Frrrrrrrrrank/Underwater-Communication/underwaterCom.kicad_pcb

## KiCad design underwaterCom.kicad_pcb (2026-06-12)

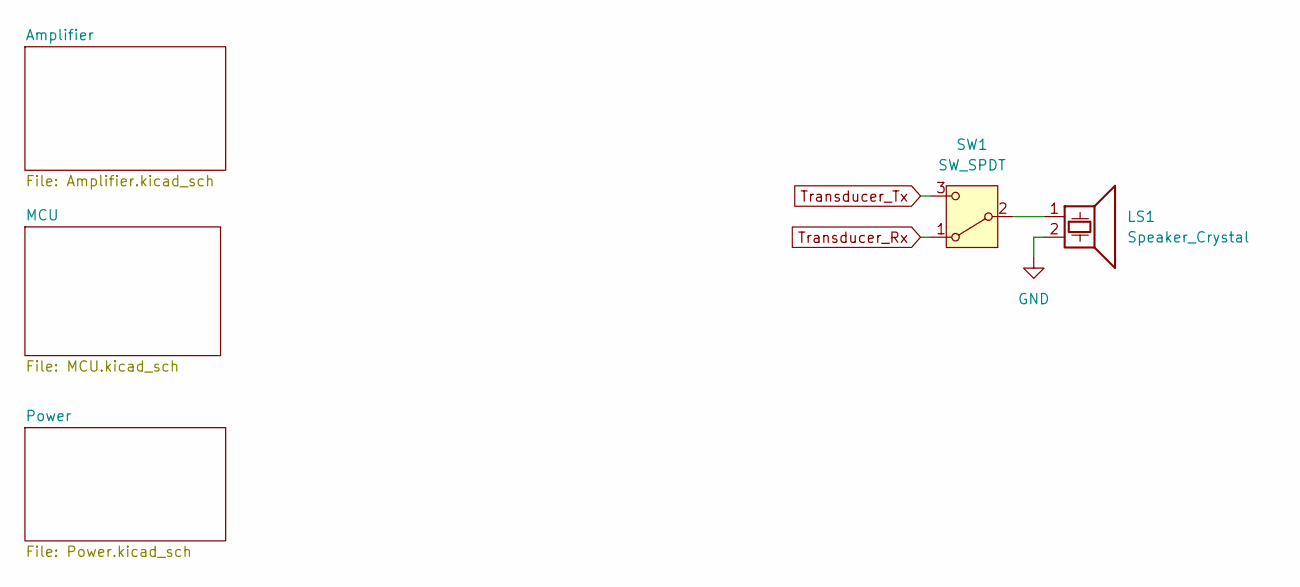
[picture p1: schematic underwaterCom.kicad_sch]

Parts:
LS1: Speaker_Crystal; PinHeader_1x02_P2.54mm_Vertical
SW1: SW_SPDT; Nidec_Copal_CAS-120A

Connections:
GND: LS1.2; also elsewhere on the board
unnamed: LS1.1, SW1.2 (B)
Transducer_Rx: SW1.1 (A); also elsewhere on the board
Transducer_Tx: SW1.3 (C); also elsewhere on the board

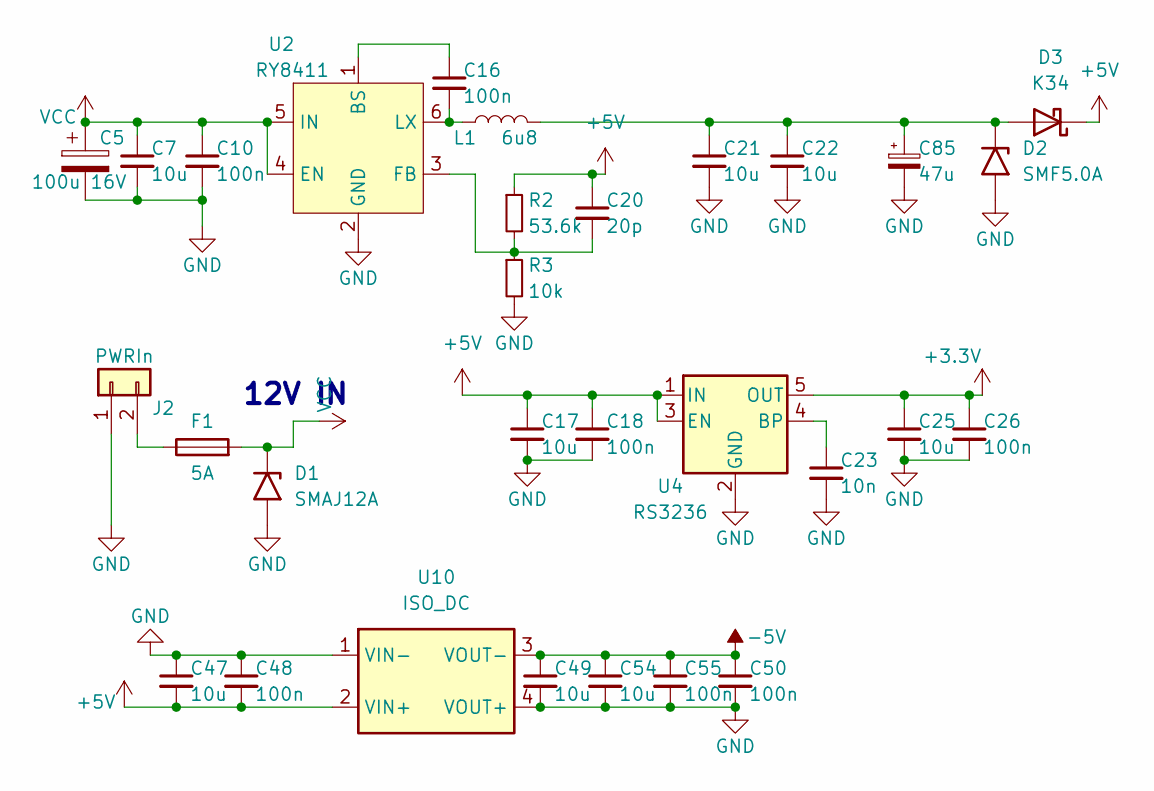
[picture p2: schematic Power.kicad_sch]

Parts:
C5: 100u 16V; CP_Radial_D6.3mm_P2.50mm
C7, C21, C22: 10u; C_1206_3216Metric
C10, C16, C18, C26, C48, C50, C55: 100n; C_0603_1608Metric
C17, C25, C47, C49, C54: 10u; C_0603_1608Metric
C20: 20p; C_0603_1608Metric
C23: 10n; C_0603_1608Metric
C85: 47u; CP_EIA-3216-18_Kemet-A_Pad1.58x1.35mm_HandSolder
D1: SMAJ12A; D_SMA
D2: SMF5.0A; D_SMF
D3: K34; D_SOD-123F
F1: 5A; Fuse_1206_3216Metric
J2: PWRIn; AMASS_XT30U-M_1x02_P5.0mm_Vertical
L1: 6u8; L_Sunlord_MWSA0402S
R2: 53.6k; R_0603_1608Metric
R3: 10k; R_0603_1608Metric
U2: RY8411; SOT-23-6
U4: RS3236; SOT-23-5
U10: ISO_DC; ISO_POWER

Connections:
+3.3V: C25.1, C26.1, U4.5 (OUT); also elsewhere on the board
+5V: C17.1, C18.1, C20.1, C47.2, C48.2, D3.1 (K), R2.1, U4.1 (IN), U4.3 (EN), U10.2 (VIN+); also elsewhere on the board
-5V: C49.1, C50.1, C54.1, C55.1, U10.3 (VOUT-); also elsewhere on the board
GND: C5.2, C7.2, C10.2, C17.2, C18.2, C21.2, C22.2, C23.2, C25.2, C26.2, C47.1, C48.1, C49.2, C50.2, C54.2, C55.2, C85.2, D1.2 (A2), D2.2 (A2), J2.1, R3.2, U2.2 (GND), U4.2 (GND), U10.1 (VIN-), U10.4 (VOUT+); also elsewhere on the board
unnamed: C21.1, C22.1, C85.1, D2.1 (A1), D3.2 (A), L1.2
unnamed: F1.1, J2.2
unnamed: C16.1, U2.1 (BS)
unnamed: C20.2, R2.2, R3.1, U2.3 (FB)
unnamed: C16.2, L1.1, U2.6 (LX)
unnamed: C23.1, U4.4 (BP)
VCC: C5.1, C7.1, C10.1, D1.1 (A1), F1.2, U2.4 (EN), U2.5 (IN); also elsewhere on the board

Notes on the sheet:
12V IN

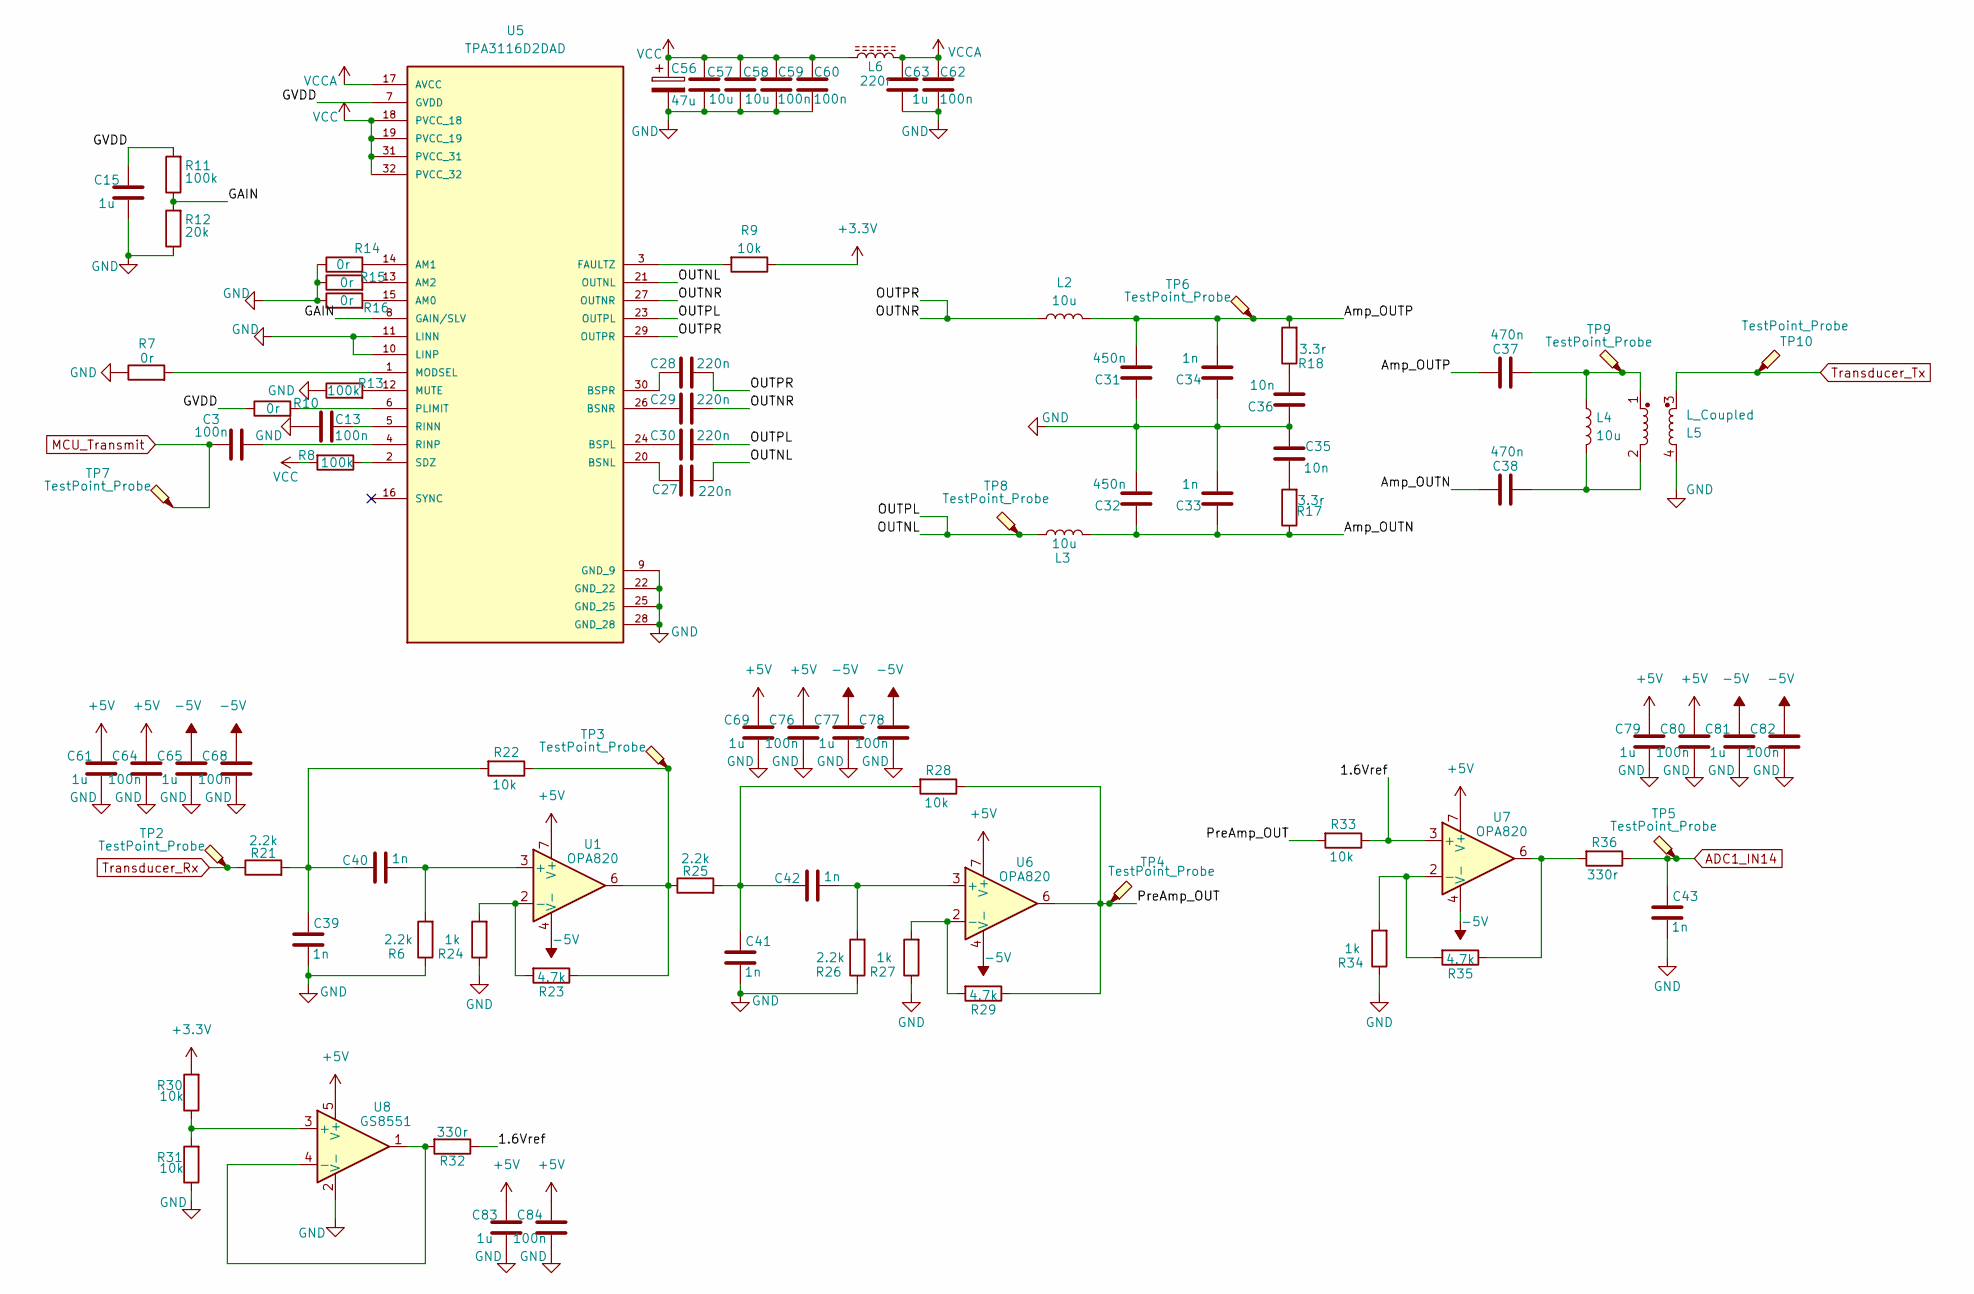
[picture p3: schematic Amplifier.kicad_sch]

Parts:
C3, C13, C59, C60, C62, C64, C68, C76, C78, C80, C82, C84: 100n; C_0603_1608Metric
C15, C61, C63, C65, C69, C77, C79, C81, C83: 1u; C_0603_1608Metric
C27, C28, C29, C30: 220n; C_0603_1608Metric
C31, C32: 450n; C_0603_1608Metric
C33, C34, C39, C40, C41, C42, C43: 1n; C_0603_1608Metric
C35, C36: 10n; C_0603_1608Metric
C37, C38: 470n; C_1206_3216Metric
C56: 47u; CP_Radial_D6.3mm_P2.50mm
C57, C58: 10u; C_1206_3216Metric
L2, L3, L4: 10u; L_Sunlord_MWSA0402S
L5: L_Coupled; L_CommonModeChoke_TDK_ATB322515
L6: 220r; L_0603_1608Metric
R6, R21, R25, R26: 2.2k; R_0603_1608Metric
R7, R10, R14, R15, R16: 0r; R_0603_1608Metric
R8, R11, R13: 100k; R_0603_1608Metric
R9, R22, R28, R30, R31, R33: 10k; R_0603_1608Metric
R12: 20k; R_0603_1608Metric
R17, R18: 3.3r; R_0603_1608Metric
R23, R29, R35: 4.7k; R_0603_1608Metric
R24, R27, R34: 1k; R_0603_1608Metric
R32, R36: 330r; R_0603_1608Metric
TP2, TP3, TP4, TP5, TP6, TP7, TP8, TP9, TP10: TestPoint_Probe; Testpoint_1.2_0.8
U1, U6, U7: OPA820; SOIC-8_3.9x4.9mm_P1.27mm
U5: TPA3116D2DAD; SOP65P810X115-32N; PARTREV G
U8: GS8551; SOT-23-5

Connections:
+3.3V: R9.1, R30.2; also elsewhere on the board
+5V: C61.2, C64.2, C69.2, C76.2, C79.2, C80.2, C83.2, C84.2, U1.7 (V+), U6.7 (V+), U7.7 (V+), U8.5 (V+); also elsewhere on the board
-5V: C65.2, C68.2, C77.2, C78.2, C81.2, C82.2, U1.4 (V-), U6.4 (V-), U7.4 (V-); also elsewhere on the board
/Amplifier/1.6Vref: R32.1, R33.1, U7.3 (+)
/Amplifier/Amp_OUTN: C32.2, C33.2, C38.1, L3.2, R17.1
/Amplifier/Amp_OUTP: C31.1, C34.1, C37.1, L2.2, R18.2, TP6.1
/Amplifier/GAIN: R11.1, R12.2, U5.8 (GAIN/SLV)
/Amplifier/GVDD: C15.2, R10.1, R11.2, U5.7 (GVDD)
/Amplifier/OUTNL: C27.1, C30.1, L3.1, TP8.1, U5.21 (OUTNL), U5.23 (OUTPL)
/Amplifier/OUTNR: C28.1, C29.1, L2.1, U5.27 (OUTNR), U5.29 (OUTPR)
/Amplifier/PreAmp_OUT: R28.1, R29.1, R33.2, TP4.1, U6.6
ADC1_IN14: C43.2, R36.1, TP5.1; also elsewhere on the board
GND: C13.1, C15.1, C31.2, C32.1, C33.1, C34.2, C35.2, C36.2, C39.1, C41.1, C43.1, C56.2, C57.2, C58.2, C59.1, C60.1, C61.1, C62.1, C63.1, C64.1, C65.1, C68.1, C69.1, C76.1, C77.1, C78.1, C79.1, C80.1, C81.1, C82.1, C83.1, C84.1, L5.4, R6.1, R7.1, R12.1, R13.1, R14.1, R15.1, R16.1, R24.1, R26.1, R27.1, R31.1, R34.1, U5.9 (GND_9), U5.10 (LINP), U5.11 (LINN), U5.22 (GND_22), U5.25 (GND_25), U5.28 (GND_28), U8.2 (V-); also elsewhere on the board
MCU_Transmit: C3.1, TP7.1; also elsewhere on the board
unnamed: C35.1, R17.2
unnamed: C36.1, R18.1
unnamed: C37.2, L4.1, L5.1, TP9.1
unnamed: C38.2, L4.2, L5.2
unnamed: C39.2, C40.2, R21.2, R22.2
unnamed: C41.2, C42.2, R25.2, R28.2
unnamed: R22.1, R23.1, R25.1, TP3.1, U1.6
unnamed: R35.1, R36.2, U7.6
unnamed: C40.1, R6.2, U1.3 (+)
unnamed: R23.2, R24.2, U1.2 (-)
unnamed: R16.2, U5.15 (AM0)
unnamed: R14.2, U5.14 (AM1)
unnamed: R15.2, U5.13 (AM2)
unnamed: C27.2, U5.20 (BSNL)
unnamed: C29.2, U5.26 (BSNR)
unnamed: C30.2, U5.24 (BSPL)
unnamed: C28.2, U5.30 (BSPR)
unnamed: R9.2, U5.3 (FAULTZ)
unnamed: R7.2, U5.1 (MODSEL)
unnamed: R13.2, U5.12 (MUTE)
unnamed: R10.2, U5.6 (PLIMIT)
unnamed: C13.2, U5.5 (RINN)
unnamed: C3.2, U5.4 (RINP)
unnamed: R8.1, U5.2 (SDZ)
unnamed: C42.1, R26.2, U6.3 (+)
unnamed: R27.2, R29.2, U6.2 (-)
unnamed: R34.2, R35.2, U7.2 (-)
unnamed: R30.1, R31.2, U8.3 (+)
unnamed: R32.2, U8.1, U8.4 (-)
Transducer_Rx: R21.1, TP2.1; also elsewhere on the board
Transducer_Tx: L5.3, TP10.1; also elsewhere on the board
VCC: C56.1, C57.1, C58.1, C59.2, C60.2, L6.1, R8.2, U5.18 (PVCC_18), U5.19 (PVCC_19), U5.31 (PVCC_31), U5.32 (PVCC_32); also elsewhere on the board
VCCA: C62.2, C63.2, L6.2, U5.17 (AVCC)

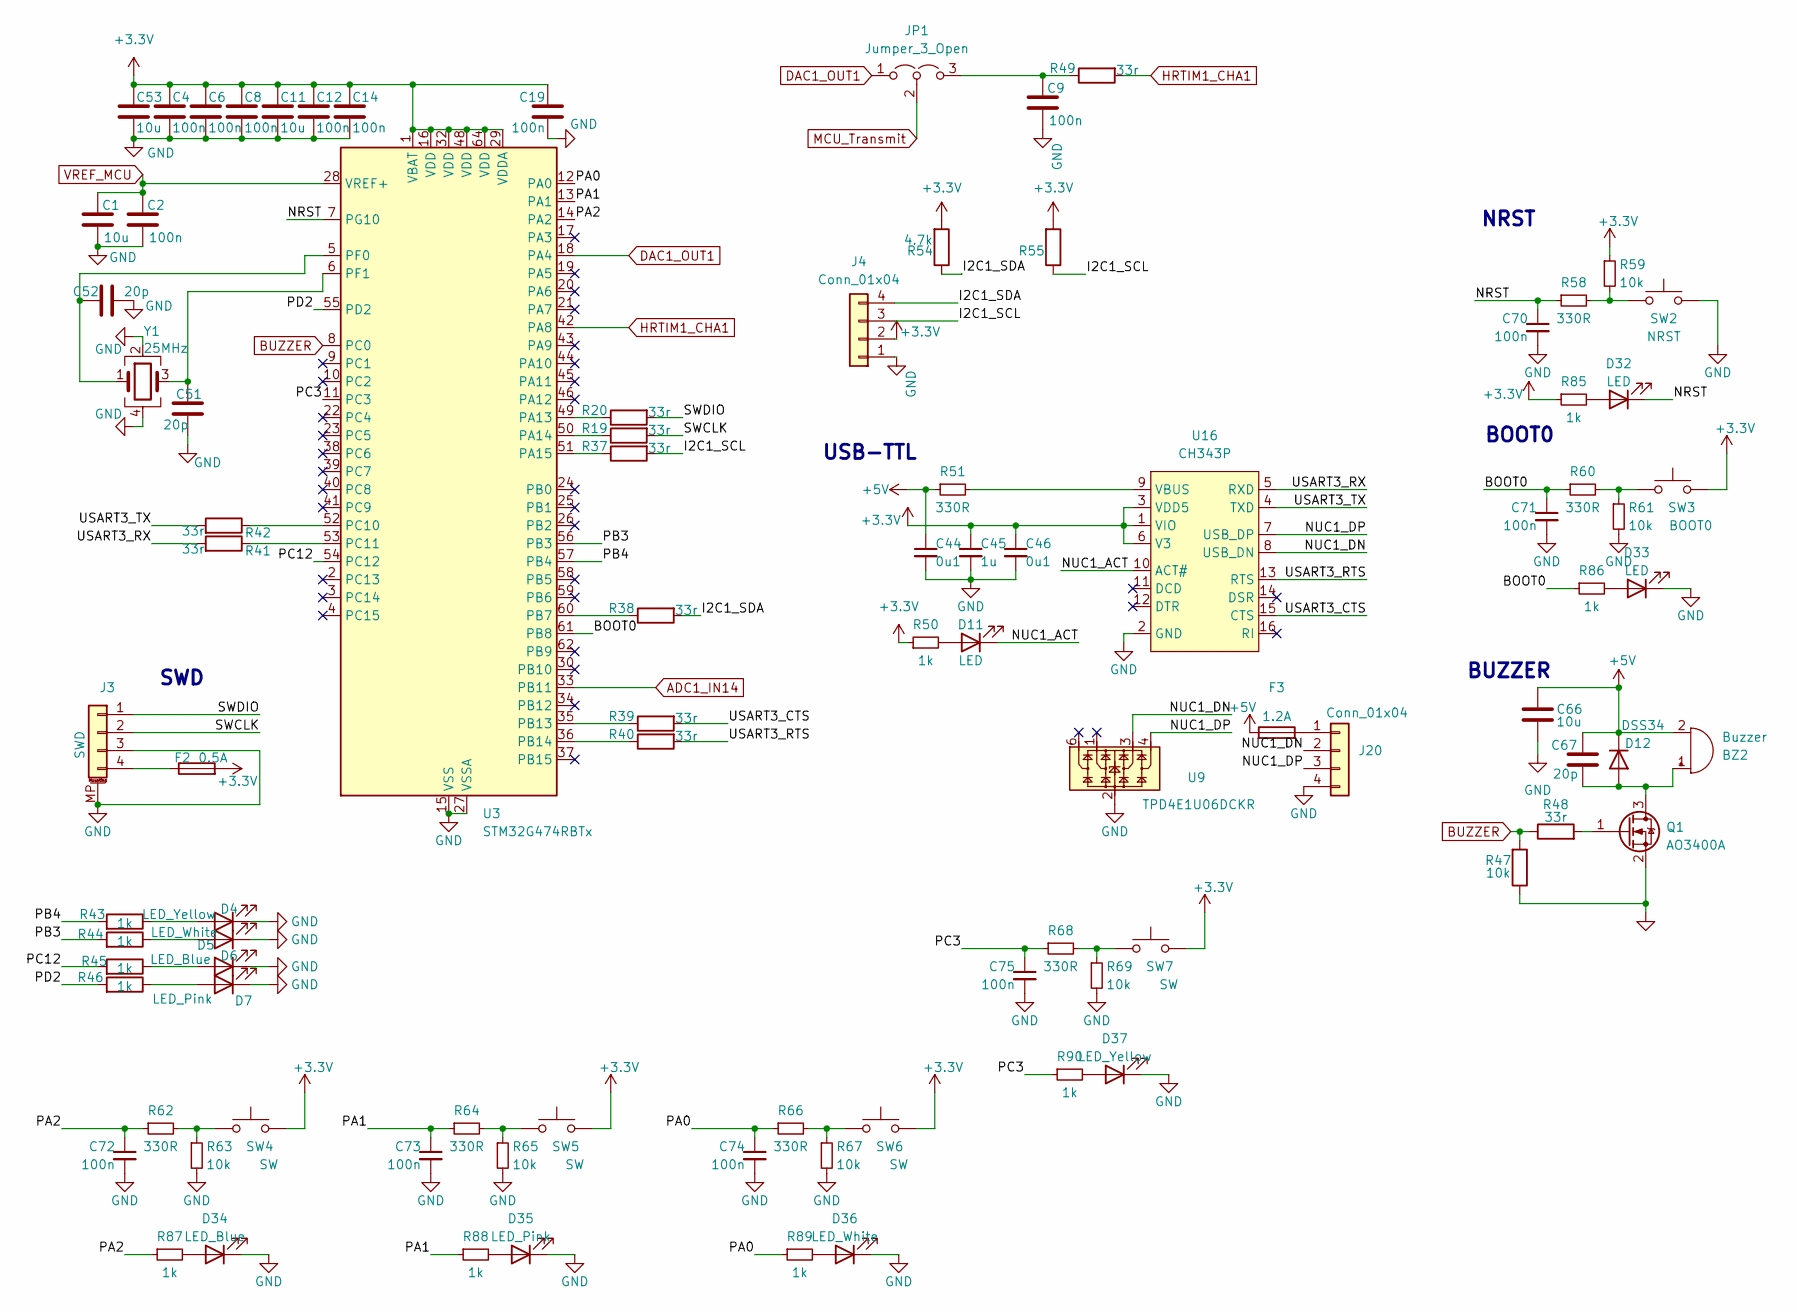
[picture p4: schematic MCU.kicad_sch]

Parts:
BZ2: Buzzer; MLT-9032
C1, C11, C53, C66: 10u; C_0603_1608Metric
C2, C4, C6, C8, C9, C12, C14, C19, C70, C71, C72, C73, C74, C75: 100n; C_0603_1608Metric
C44, C46: 0u1; C_0603_1608Metric
C45: 1u; C_0603_1608Metric
C51, C52, C67: 20p; C_0603_1608Metric
D4, D37: LED_Yellow; LED_0603_1608Metric
D5, D36: LED_White; LED_0603_1608Metric
D6, D34: LED_Blue; LED_0603_1608Metric
D7, D35: LED_Pink; LED_0603_1608Metric
D11, D32, D33: LED; LED_0603_1608Metric
D12: DSS34; D_SMF
F2: 0.5A; Fuse_1206_3216Metric
F3: 1.2A; Fuse_1210_3225Metric
J3: SWD; Molex_PicoBlade_53261-0471_1x04-1MP_P1.25mm_Horizontal
J4: Conn_01x04; PinHeader_1x04_P2.54mm_Vertical
J20: Conn_01x04; JST_PH_B4B-PH-K_1x04_P2.00mm_Vertical
JP1: Jumper_3_Open; PinHeader_1x03_P1.00mm_Vertical
Q1: AO3400A; SOT-23
R19, R20, R37, R38, R39, R40, R41, R42, R48, R49: 33r; R_0603_1608Metric
R43, R44, R45, R46, R50, R85, R86, R87, R88, R89, R90: 1k; R_0603_1608Metric
R47, R59, R61, R63, R65, R67, R69: 10k; R_0603_1608Metric
R51, R58, R60, R62, R64, R66, R68: 330R; R_0603_1608Metric
R54, R55: 4.7k; R_0603_1608Metric
SW2: NRST; Panasonic_EVQPUL_EVQPUC
SW3: BOOT0; Panasonic_EVQPUL_EVQPUC
SW4, SW5, SW6, SW7: SW; SW_SPST_TL3342
U3: STM32G474RBTx; LQFP-64_10x10mm_P0.5mm
U9: TPD4E1U06DCKR; SOT-363_SC-70-6
U16: CH343P; TQFN-16-1EP_3x3mm_P0.5mm_EP1.6x1.6mm
Y1: 25MHz; Crystal_SMD_3225-4Pin_3.2x2.5mm

Connections:
+3.3V: C4.1, C6.1, C8.1, C11.1, C12.1, C14.1, C19.1, C45.1, C46.1, C53.1, F2.2, J4.2, R50.1, R54.2, R55.2, R59.1, R85.1, SW3.2, SW4.2, SW5.2, SW6.2, SW7.2, U3.1 (VBAT), U3.16 (VDD), U3.29 (VDDA), U3.32 (VDD), U3.48 (VDD), U3.64 (VDD), U16.1 (VIO), U16.3 (VDD5), U16.6 (V3); also elsewhere on the board
+5V: BZ2.2 (-), C44.1, C66.1, C67.1, D12.1 (K), F3.1, R51.1; also elsewhere on the board
/MCU/BOOT0: C71.1, R60.1, R86.1, U3.61 (PB8)
/MCU/I2C1_SCL: J4.3, R37.2, R55.1
/MCU/I2C1_SDA: J4.4, R38.2, R54.1
/MCU/NRST: C70.1, D32.1 (K), R58.1, U3.7 (PG10)
/MCU/NUC1_ACT: D11.1 (K), U16.10 (ACT#)
/MCU/NUC1_DN: J20.2, U9.3, U16.8 (USB_DN)
/MCU/NUC1_DP: J20.3, U9.4, U16.7 (USB_DP)
/MCU/PA0: C74.1, R66.1, R89.1, U3.12 (PA0)
/MCU/PA1: C73.1, R64.1, R88.1, U3.13 (PA1)
/MCU/PA2: C72.1, R62.1, R87.1, U3.14 (PA2)
/MCU/PB3: R44.2, U3.56 (PB3)
/MCU/PB4: R43.2, U3.57 (PB4)
/MCU/PC3: C75.1, R68.1, R90.1, U3.11 (PC3)
/MCU/PC12: R45.2, U3.54 (PC12)
/MCU/PD2: R46.2, U3.55 (PD2)
/MCU/SWCLK: J3.2, R19.2
/MCU/SWDIO: J3.1, R20.2
/MCU/USART3_CTS: R39.2, U16.15 (CTS)
/MCU/USART3_RTS: R40.2, U16.13 (RTS)
/MCU/USART3_RX: R41.2, U16.5 (RXD)
/MCU/USART3_TX: R42.2, U16.4 (TXD)
ADC1_IN14: U3.33 (PB11); also elsewhere on the board
BUZZER: R47.2, R48.1, U3.8 (PC0)
DAC1_OUT1: JP1.1 (A), U3.18 (PA4)
GND: C1.2, C2.2, C4.2, C6.2, C8.2, C9.2, C11.2, C12.2, C14.2, C19.2, C44.2, C45.2, C46.2, C51.2, C52.2, C53.2, C66.2, C70.2, C71.2, C72.2, C73.2, C74.2, C75.2, D4.1 (K), D5.1 (K), D6.1 (K), D7.1 (K), D33.1 (K), D34.1 (K), D35.1 (K), D36.1 (K), D37.1 (K), J3.3, J3.MP (MountPin), J4.1, J20.4, Q1.2 (S), R47.1, R61.2, R63.2, R65.2, R67.2, R69.2, SW2.2, U3.15 (VSS), U3.27 (VSSA), U3.31 (VSS), U3.47 (VSS), U3.63 (VSS), U9.2, U16.2 (GND), U16.17 (GND), Y1.2, Y1.4; also elsewhere on the board
HRTIM1_CHA1: R49.2, U3.42 (PA8)
MCU_Transmit: JP1.2 (C); also elsewhere on the board
unnamed: BZ2.1 (+), C67.2, D12.2 (A), Q1.3 (D)
unnamed: D4.2 (A), R43.1
unnamed: D5.2 (A), R44.1
unnamed: D6.2 (A), R45.1
unnamed: D7.2 (A), R46.1
unnamed: D11.2 (A), R50.2
unnamed: D32.2 (A), R85.2
unnamed: D33.2 (A), R86.2
unnamed: D34.2 (A), R87.2
unnamed: D35.2 (A), R88.2
unnamed: D36.2 (A), R89.2
unnamed: D37.2 (A), R90.2
unnamed: F2.1, J3.4
unnamed: F3.2, J20.1
unnamed: C9.1, JP1.3 (B), R49.1
unnamed: Q1.1 (G), R48.2
unnamed: R58.2, R59.2, SW2.1
unnamed: R60.2, R61.1, SW3.1
unnamed: R62.2, R63.1, SW4.1
unnamed: R64.2, R65.1, SW5.1
unnamed: R66.2, R67.1, SW6.1
unnamed: R68.2, R69.1, SW7.1
unnamed: R20.1, U3.49 (PA13)
unnamed: R19.1, U3.50 (PA14)
unnamed: R37.1, U3.51 (PA15)
unnamed: R38.1, U3.60 (PB7)
unnamed: R39.1, U3.35 (PB13)
unnamed: R40.1, U3.36 (PB14)
unnamed: R42.1, U3.52 (PC10)
unnamed: R41.1, U3.53 (PC11)
unnamed: C52.1, U3.5 (PF0), Y1.1
unnamed: C51.1, U3.6 (PF1), Y1.3
unnamed: R51.2, U16.9 (VBUS)
VREF_MCU: C1.1, C2.1, U3.28 (VREF+)

Notes on the sheet:
SWD
BUZZER
BOOT0
USB-TTL
NRST

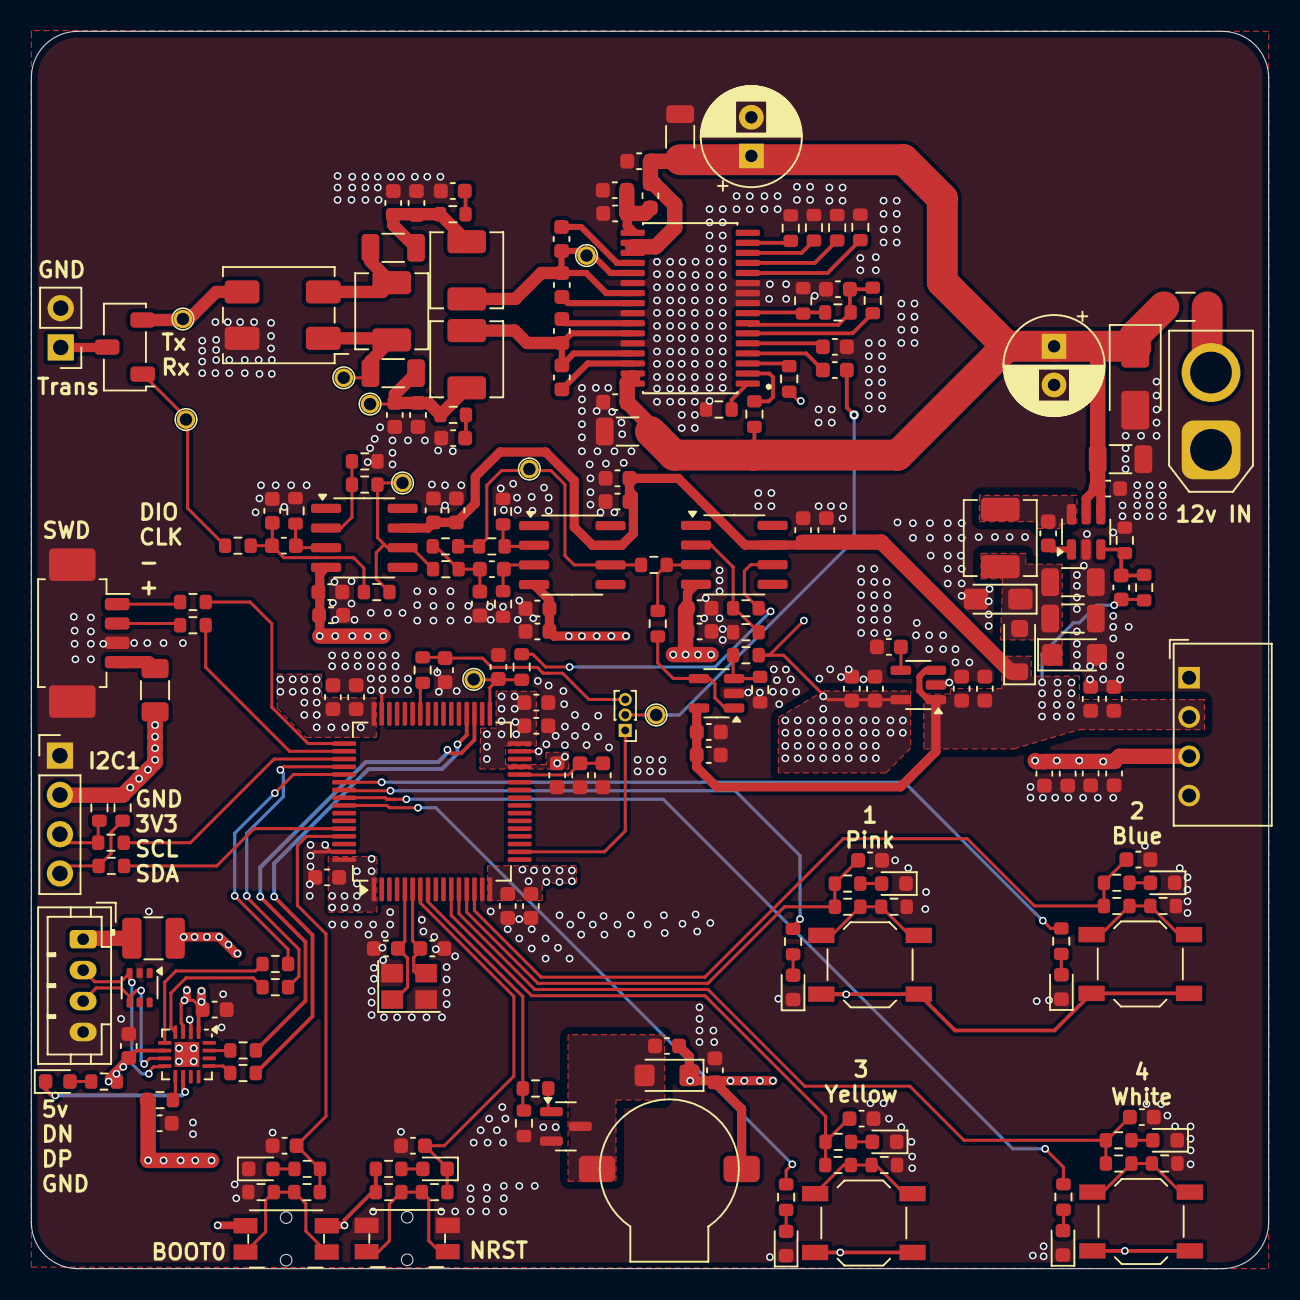
[picture p5: board underwaterCom.kicad_pcb from above]

Board: 4 copper layers, 80.0 x 80.0 mm, 212 parts (0 on the bottom side), 112 nets.
