Frrrrrrrrrank/Underwater-Communication/software/Underwatercomm_core/rx_driver.cpp

#include "rx_driver.hpp"

#include "underwatercomm_config.hpp"

#include <math.h>

#if UNDERWATERCOMM_ENABLE_RX_FFT
extern "C" {
#include "arm_math.h"
}
#endif

namespace underwatercomm {
namespace {

constexpr uint32_t SAMPLE_RATE_HZ = 500000U;
constexpr uint32_t FFT_SAMPLE_COUNT = 1024U;
constexpr uint32_t ADC_DMA_SAMPLE_COUNT = FFT_SAMPLE_COUNT * 2U;
constexpr uint32_t TARGET_FREQUENCY_HZ = 75000U;

#if UNDERWATERCOMM_ENABLE_RX_GOERTZEL
// Exact 75 kHz Goertzel coefficient for fs = 500 kHz:
//   coeff = 2 * cos(2*pi*75000/500000)
// Keeping this as a constant avoids calling cosf() during bring-up.
constexpr float TWO_PI_F = 6.2831853072F;
constexpr float GOERTZEL_TARGET_FREQUENCY_HZ = 75000.0F;
constexpr float GOERTZEL_TARGET_COEFFICIENT = 1.1755705046F;

#if UNDERWATERCOMM_ENABLE_RX_GOERTZEL_SWEEP
// A narrow sweep is enough for current bring-up because the TX waveform and
// transducer are both centered near 75 kHz. The 1 kHz step is intentionally
// coarse: it gives a useful frequency estimate without burning as much CPU as
// a full FFT on every DMA half-buffer.
constexpr uint32_t GOERTZEL_SWEEP_START_HZ =
    UNDERWATERCOMM_RX_SWEEP_START_HZ;
constexpr uint32_t GOERTZEL_SWEEP_STOP_HZ = UNDERWATERCOMM_RX_SWEEP_STOP_HZ;
constexpr uint32_t GOERTZEL_SWEEP_STEP_HZ = UNDERWATERCOMM_RX_SWEEP_STEP_HZ;
constexpr uint32_t GOERTZEL_SWEEP_BIN_COUNT =
    ((GOERTZEL_SWEEP_STOP_HZ - GOERTZEL_SWEEP_START_HZ) /
     GOERTZEL_SWEEP_STEP_HZ) +
    1U;
constexpr uint32_t FSK_LOW_FREQUENCY_HZ =
    UNDERWATERCOMM_TX_LOW_FREQUENCY_HZ;
constexpr uint32_t FSK_HIGH_FREQUENCY_HZ =
    UNDERWATERCOMM_TX_HIGH_FREQUENCY_HZ;
constexpr float FSK_LOW_POWER_WEIGHT =
    UNDERWATERCOMM_RX_FSK_LOW_POWER_WEIGHT;
constexpr float FSK_HIGH_POWER_WEIGHT =
    UNDERWATERCOMM_RX_FSK_HIGH_POWER_WEIGHT;
constexpr uint32_t FSK_LOW_SWEEP_INDEX =
    (FSK_LOW_FREQUENCY_HZ - GOERTZEL_SWEEP_START_HZ) /
    GOERTZEL_SWEEP_STEP_HZ;
constexpr uint32_t FSK_HIGH_SWEEP_INDEX =
    (FSK_HIGH_FREQUENCY_HZ - GOERTZEL_SWEEP_START_HZ) /
    GOERTZEL_SWEEP_STEP_HZ;
constexpr float FSK_SCORE_EPSILON = 1.0F;
static_assert(GOERTZEL_SWEEP_BIN_COUNT ==
                  UNDERWATERCOMM_RX_DEBUG_SWEEP_BIN_COUNT,
              "RX debug sweep array size must match Goertzel sweep bins");
static_assert(GOERTZEL_SWEEP_STEP_HZ > 0U,
              "RX Goertzel sweep step must be non-zero");
static_assert(GOERTZEL_SWEEP_STOP_HZ >= GOERTZEL_SWEEP_START_HZ,
              "RX Goertzel sweep stop must be >= start");
static_assert(FSK_LOW_FREQUENCY_HZ >= GOERTZEL_SWEEP_START_HZ,
              "FSK low frequency must be >= RX sweep start");
static_assert(FSK_HIGH_FREQUENCY_HZ >= GOERTZEL_SWEEP_START_HZ,
              "FSK high frequency must be >= RX sweep start");
static_assert(FSK_LOW_SWEEP_INDEX < GOERTZEL_SWEEP_BIN_COUNT,
              "FSK low frequency must be inside the Goertzel sweep");
static_assert(FSK_HIGH_SWEEP_INDEX < GOERTZEL_SWEEP_BIN_COUNT,
              "FSK high frequency must be inside the Goertzel sweep");
static_assert(((FSK_LOW_FREQUENCY_HZ - GOERTZEL_SWEEP_START_HZ) %
               GOERTZEL_SWEEP_STEP_HZ) == 0U,
              "FSK low frequency must align to an RX sweep bin");
static_assert(((FSK_HIGH_FREQUENCY_HZ - GOERTZEL_SWEEP_START_HZ) %
               GOERTZEL_SWEEP_STEP_HZ) == 0U,
              "FSK high frequency must align to an RX sweep bin");

// First-order smoothing for the Goertzel sweep debug values:
//   filtered = filtered + alpha * (new_value - filtered)
// A value near 0.2 keeps the display steady while still reacting within a few
// analysis frames. Raise it for faster response; lower it for calmer display.
constexpr float SWEEP_FILTER_ALPHA = UNDERWATERCOMM_RX_SWEEP_FILTER_ALPHA;
#endif
#endif

#if UNDERWATERCOMM_ENABLE_RX_FFT
constexpr uint32_t MIN_ANALYSIS_FREQUENCY_HZ = 20000U;
constexpr uint32_t MAX_ANALYSIS_FREQUENCY_HZ = 180000U;
constexpr float PI_F = 3.14159265358979323846F;
#endif

enum class ReadyBlock : uint8_t {
  NONE,
  FIRST_HALF,
  SECOND_HALF,
};

// DMA writes 2048 raw ADC samples in circular mode. Each half-buffer contains
// one complete 1024-point analysis frame, so the main loop can process one half
// while DMA fills the other half.
alignas(4) uint16_t g_adc_raw_buffer[ADC_DMA_SAMPLE_COUNT];

#if UNDERWATERCOMM_ENABLE_RX_FFT
// FFT working buffers are static to keep large arrays off the call stack.
float g_fft_input[FFT_SAMPLE_COUNT];
float g_fft_output[FFT_SAMPLE_COUNT];
float g_window[FFT_SAMPLE_COUNT];
arm_rfft_fast_instance_f32 g_fft_instance;
#endif

ADC_HandleTypeDef *g_adc = nullptr;
TIM_HandleTypeDef *g_trigger_timer = nullptr;
volatile ReadyBlock g_ready_block = ReadyBlock::NONE;
volatile bool g_dma_overrun = false;
bool g_started = false;
#if UNDERWATERCOMM_ENABLE_RX_FFT
bool g_fft_ready = false;
#endif
bool g_has_result = false;
uint32_t g_block_counter = 0U;
RxAnalysisResult g_latest_result = {};

#if UNDERWATERCOMM_ENABLE_RX_GOERTZEL && UNDERWATERCOMM_ENABLE_RX_GOERTZEL_SWEEP
float g_goertzel_sweep_coefficients[GOERTZEL_SWEEP_BIN_COUNT];
float g_filtered_sweep_power[GOERTZEL_SWEEP_BIN_COUNT];
bool g_goertzel_sweep_ready = false;
bool g_sweep_filter_has_history = false;
#endif

#if UNDERWATERCOMM_ENABLE_RX_FFT
uint32_t FrequencyToBin(uint32_t frequency_hz) {
  // Nearest FFT bin. With 500 kS/s and 1024 samples, each bin is 488.28125 Hz.
  return ((frequency_hz * FFT_SAMPLE_COUNT) + (SAMPLE_RATE_HZ / 2U)) /
         SAMPLE_RATE_HZ;
}

float BinToFrequency(float bin) {
  return (bin * static_cast<float>(SAMPLE_RATE_HZ)) /
         static_cast<float>(FFT_SAMPLE_COUNT);
}

float MagnitudeSquaredForBin(uint32_t bin) {
  // CMSIS real FFT packs bin 0 at output[0] and Nyquist at output[1].
  // Other bins are interleaved real/imag pairs.
  if (bin == 0U) {
    return g_fft_output[0] * g_fft_output[0];
  }

  if (bin >= (FFT_SAMPLE_COUNT / 2U)) {
    return g_fft_output[1] * g_fft_output[1];
  }

  const float real = g_fft_output[2U * bin];
  const float imag = g_fft_output[(2U * bin) + 1U];
  return (real * real) + (imag * imag);
}

float NormalizedMagnitude(uint32_t bin) {
  return sqrtf(MagnitudeSquaredForBin(bin)) /
         static_cast<float>(FFT_SAMPLE_COUNT);
}

float InterpolatePeakBin(uint32_t peak_bin) {
  if ((peak_bin <= 1U) || (peak_bin >= ((FFT_SAMPLE_COUNT / 2U) - 2U))) {
    return static_cast<float>(peak_bin);
  }

  const float left = MagnitudeSquaredForBin(peak_bin - 1U);
  const float center = MagnitudeSquaredForBin(peak_bin);
  const float right = MagnitudeSquaredForBin(peak_bin + 1U);
  const float denominator = left - (2.0F * center) + right;

  if (denominator == 0.0F) {
    return static_cast<float>(peak_bin);
  }

  const float offset = 0.5F * (left - right) / denominator;
  return static_cast<float>(peak_bin) + offset;
}

void BuildHannWindow() {
  // Windowing reduces spectral leakage. This is useful while the incoming
  // acoustic burst is not exactly aligned to the 1024-sample FFT frame.
  for (uint32_t i = 0U; i < FFT_SAMPLE_COUNT; ++i) {
    const float phase =
        (2.0F * PI_F * static_cast<float>(i)) /
        static_cast<float>(FFT_SAMPLE_COUNT - 1U);
    g_window[i] = 0.5F - (0.5F * cosf(phase));
  }
}
#endif

void MarkBlockReady(ADC_HandleTypeDef *adc, ReadyBlock block) {
  // This runs inside the DMA interrupt callback, so do the minimum work here:
  // just record which half is ready. The FFT stays in Process().
  if ((adc != g_adc) || !g_started) {
    return;
  }

  if (g_ready_block != ReadyBlock::NONE) {
    // The main loop did not process the previous half-buffer before another
    // DMA callback arrived. Keep running, but expose this in the result.
    g_dma_overrun = true;
  }

  g_ready_block = block;
}

#if UNDERWATERCOMM_ENABLE_RX_GOERTZEL
float CalculateGoertzelPower(const volatile uint16_t *samples,
                             float average_raw,
                             float coefficient) {
  float delayed_sample_1 = 0.0F;
  float delayed_sample_2 = 0.0F;

  for (uint32_t i = 0U; i < FFT_SAMPLE_COUNT; ++i) {
    const float centered_sample = static_cast<float>(samples[i]) - average_raw;
    const float current_sample =
        centered_sample + (coefficient * delayed_sample_1) -
        delayed_sample_2;

    delayed_sample_2 = delayed_sample_1;
    delayed_sample_1 = current_sample;
  }

  // This is the squared magnitude at the target frequency. It is not scaled
  // like an FFT bin, but it is stable for threshold comparisons.
  return (delayed_sample_1 * delayed_sample_1) +
         (delayed_sample_2 * delayed_sample_2) -
         (coefficient * delayed_sample_1 * delayed_sample_2);
}

float ClampGoertzelPower(float power) {
  // Floating-point roundoff can make a very small negative value when there is
  // almost no energy in the bin. Clamp before sqrtf() so debug values stay sane.
  return (power > 0.0F) ? power : 0.0F;
}

float GoertzelMagnitudeFromPower(float power) {
  return sqrtf(ClampGoertzelPower(power)) /
         static_cast<float>(FFT_SAMPLE_COUNT);
}

#if UNDERWATERCOMM_ENABLE_RX_GOERTZEL_SWEEP
float GoertzelCoefficientForFrequency(uint32_t frequency_hz) {
  const float normalized_frequency =
      static_cast<float>(frequency_hz) / static_cast<float>(SAMPLE_RATE_HZ);
  return 2.0F * cosf(TWO_PI_F * normalized_frequency);
}

uint32_t GoertzelSweepFrequencyForIndex(uint32_t index) {
  return GOERTZEL_SWEEP_START_HZ + (index * GOERTZEL_SWEEP_STEP_HZ);
}

void PrepareGoertzelSweep() {
  if (g_goertzel_sweep_ready) {
    return;
  }

  // Coefficients depend only on sample rate and test frequencies, so calculate
  // them once at startup instead of spending time on cosf() in the main loop.
  for (uint32_t i = 0U; i < GOERTZEL_SWEEP_BIN_COUNT; ++i) {
    g_goertzel_sweep_coefficients[i] =
        GoertzelCoefficientForFrequency(GoertzelSweepFrequencyForIndex(i));
  }

  g_goertzel_sweep_ready = true;
}

float UpdateFilteredSweepPower(uint32_t index, float new_power) {
  if (!g_sweep_filter_has_history) {
    g_filtered_sweep_power[index] = new_power;
    return new_power;
  }

  const float previous_power = g_filtered_sweep_power[index];
  const float filtered_power =
      previous_power + (SWEEP_FILTER_ALPHA * (new_power - previous_power));
  g_filtered_sweep_power[index] = filtered_power;
  return filtered_power;
}
#endif
#endif

void AnalyzeBlock(const volatile uint16_t *samples, bool dma_overrun) {
  uint32_t min_raw = 0xFFFFU;
  uint32_t max_raw = 0U;
  uint64_t sum_raw = 0U;

  for (uint32_t i = 0U; i < FFT_SAMPLE_COUNT; ++i) {
    const uint32_t raw = samples[i];
    sum_raw += raw;

    if (raw < min_raw) {
      min_raw = raw;
    }

    if (raw > max_raw) {
      max_raw = raw;
    }
  }

  const float average_raw =
      static_cast<float>(sum_raw) / static_cast<float>(FFT_SAMPLE_COUNT);

  // Raw statistics are always updated. Watch these first when validating ADC DMA.
  g_latest_result.block_counter = ++g_block_counter;
  g_latest_result.sample_rate_hz = SAMPLE_RATE_HZ;
  g_latest_result.sample_count = FFT_SAMPLE_COUNT;
  g_latest_result.min_raw = static_cast<uint16_t>(min_raw);
  g_latest_result.max_raw = static_cast<uint16_t>(max_raw);
  g_latest_result.average_raw = average_raw;
  g_latest_result.weighted_low_power = 0.0F;
  g_latest_result.weighted_high_power = 0.0F;
  g_latest_result.fsk_score = 0.0F;

#if UNDERWATERCOMM_ENABLE_RX_FFT
  // Remove DC before FFT. The receiver amplifier biases the ADC signal, and a
  // strong DC bin would otherwise hide the useful nearby bins in debug views.
  for (uint32_t i = 0U; i < FFT_SAMPLE_COUNT; ++i) {
    const float centered_sample = static_cast<float>(samples[i]) - average_raw;
    g_fft_input[i] = centered_sample * g_window[i];
  }

  arm_rfft_fast_f32(&g_fft_instance, g_fft_input, g_fft_output, 0);

  uint32_t start_bin = FrequencyToBin(MIN_ANALYSIS_FREQUENCY_HZ);
  uint32_t stop_bin = FrequencyToBin(MAX_ANALYSIS_FREQUENCY_HZ);
  const uint32_t last_usable_bin = (FFT_SAMPLE_COUNT / 2U) - 1U;

  if (start_bin < 1U) {
    start_bin = 1U;
  }

  if (stop_bin > last_usable_bin) {
    stop_bin = last_usable_bin;
  }

  uint32_t peak_bin = start_bin;
  float peak_magnitude_squared = 0.0F;

  for (uint32_t bin = start_bin; bin <= stop_bin; ++bin) {
    const float magnitude_squared = MagnitudeSquaredForBin(bin);

    if (magnitude_squared > peak_magnitude_squared) {
      peak_magnitude_squared = magnitude_squared;
      peak_bin = bin;
    }
  }

  const uint32_t target_bin = FrequencyToBin(TARGET_FREQUENCY_HZ);
  const float interpolated_peak_bin = InterpolatePeakBin(peak_bin);

  g_latest_result.dominant_frequency_hz =
      BinToFrequency(interpolated_peak_bin);
  g_latest_result.dominant_magnitude =
      sqrtf(peak_magnitude_squared) / static_cast<float>(FFT_SAMPLE_COUNT);
  g_latest_result.target_frequency_hz =
      BinToFrequency(static_cast<float>(target_bin));
  // This is the energy at the nearest 75 kHz bin, not necessarily the global
  // peak. It is useful for Goertzel-style threshold tests later.
  g_latest_result.target_magnitude = NormalizedMagnitude(target_bin);
#else
  // Raw-capture bring-up mode. Leave frequency fields at zero so the debugger
  // can still inspect min/max/average without running CMSIS-DSP yet.
  g_latest_result.dominant_frequency_hz = 0.0F;
  g_latest_result.dominant_magnitude = 0.0F;
  g_latest_result.target_frequency_hz = static_cast<float>(TARGET_FREQUENCY_HZ);
  g_latest_result.target_magnitude = 0.0F;
#endif

#if UNDERWATERCOMM_ENABLE_RX_GOERTZEL
  const float target_power = CalculateGoertzelPower(
      samples, average_raw, GOERTZEL_TARGET_COEFFICIENT);
  const float target_magnitude = GoertzelMagnitudeFromPower(target_power);

  float dominant_frequency_hz = GOERTZEL_TARGET_FREQUENCY_HZ;
  float dominant_power = target_power;
  float dominant_magnitude = target_magnitude;

#if UNDERWATERCOMM_ENABLE_RX_GOERTZEL_SWEEP
  // Sweep only the small band around the expected transducer resonance. This is
  // not a full spectrum analyzer, but it is good enough to see whether the
  // strongest received tone is near the 75 kHz carrier.
  float filtered_dominant_frequency_hz = GOERTZEL_TARGET_FREQUENCY_HZ;
  float filtered_dominant_power = target_power;
  float filtered_dominant_magnitude = target_magnitude;

  g_underwatercomm_rx_debug.sweep_bin_count = GOERTZEL_SWEEP_BIN_COUNT;

  for (uint32_t i = 0U; i < GOERTZEL_SWEEP_BIN_COUNT; ++i) {
    const float sweep_power = CalculateGoertzelPower(
        samples, average_raw, g_goertzel_sweep_coefficients[i]);
    const float sweep_magnitude = GoertzelMagnitudeFromPower(sweep_power);
    const float filtered_sweep_power =
        UpdateFilteredSweepPower(i, sweep_power);
    const float filtered_sweep_magnitude =
        GoertzelMagnitudeFromPower(filtered_sweep_power);

    g_underwatercomm_rx_debug.sweep_frequency_hz[i] =
        GoertzelSweepFrequencyForIndex(i);
    g_underwatercomm_rx_debug.sweep_power[i] = sweep_power;
    g_underwatercomm_rx_debug.sweep_magnitude[i] = sweep_magnitude;
    g_underwatercomm_rx_debug.filtered_sweep_power[i] =
        filtered_sweep_power;
    g_underwatercomm_rx_debug.filtered_sweep_magnitude[i] =
        filtered_sweep_magnitude;

    if (sweep_power > dominant_power) {
      dominant_power = sweep_power;
      dominant_frequency_hz =
          static_cast<float>(GoertzelSweepFrequencyForIndex(i));
      dominant_magnitude = sweep_magnitude;
    }

    if (filtered_sweep_power > filtered_dominant_power) {
      filtered_dominant_power = filtered_sweep_power;
      filtered_dominant_frequency_hz =
          static_cast<float>(GoertzelSweepFrequencyForIndex(i));
      filtered_dominant_magnitude = filtered_sweep_magnitude;
    }
  }

  g_sweep_filter_has_history = true;

  const float low_power =
      g_underwatercomm_rx_debug.sweep_power[FSK_LOW_SWEEP_INDEX];
  const float high_power =
      g_underwatercomm_rx_debug.sweep_power[FSK_HIGH_SWEEP_INDEX];
  const float filtered_low_power =
      g_underwatercomm_rx_debug.filtered_sweep_power[FSK_LOW_SWEEP_INDEX];
  const float filtered_high_power =
      g_underwatercomm_rx_debug.filtered_sweep_power[FSK_HIGH_SWEEP_INDEX];
  const float weighted_low_power = low_power * FSK_LOW_POWER_WEIGHT;
  const float weighted_high_power = high_power * FSK_HIGH_POWER_WEIGHT;
  const float filtered_weighted_low_power =
      filtered_low_power * FSK_LOW_POWER_WEIGHT;
  const float filtered_weighted_high_power =
      filtered_high_power * FSK_HIGH_POWER_WEIGHT;
  const float fsk_power_sum =
      weighted_low_power + weighted_high_power + FSK_SCORE_EPSILON;
  const float filtered_fsk_power_sum =
      filtered_weighted_low_power + filtered_weighted_high_power +
      FSK_SCORE_EPSILON;

  // FSK score is easier to watch than two raw powers:
  //   negative -> the configured low TX frequency is stronger
  //   positive -> the configured high TX frequency is stronger
  //   near zero -> ambiguous or no strong received tone
  g_underwatercomm_rx_debug.low_frequency_hz =
      static_cast<float>(FSK_LOW_FREQUENCY_HZ);
  g_underwatercomm_rx_debug.high_frequency_hz =
      static_cast<float>(FSK_HIGH_FREQUENCY_HZ);
  g_underwatercomm_rx_debug.low_power = low_power;
  g_underwatercomm_rx_debug.high_power = high_power;
  g_underwatercomm_rx_debug.low_magnitude =
      g_underwatercomm_rx_debug.sweep_magnitude[FSK_LOW_SWEEP_INDEX];
  g_underwatercomm_rx_debug.high_magnitude =
      g_underwatercomm_rx_debug.sweep_magnitude[FSK_HIGH_SWEEP_INDEX];
  g_underwatercomm_rx_debug.weighted_low_power = weighted_low_power;
  g_underwatercomm_rx_debug.weighted_high_power = weighted_high_power;
  g_underwatercomm_rx_debug.filtered_low_power = filtered_low_power;
  g_underwatercomm_rx_debug.filtered_high_power = filtered_high_power;
  g_underwatercomm_rx_debug.filtered_low_magnitude =
      g_underwatercomm_rx_debug.filtered_sweep_magnitude[FSK_LOW_SWEEP_INDEX];
  g_underwatercomm_rx_debug.filtered_high_magnitude =
      g_underwatercomm_rx_debug.filtered_sweep_magnitude[FSK_HIGH_SWEEP_INDEX];
  g_underwatercomm_rx_debug.filtered_weighted_low_power =
      filtered_weighted_low_power;
  g_underwatercomm_rx_debug.filtered_weighted_high_power =
      filtered_weighted_high_power;
  g_underwatercomm_rx_debug.fsk_score =
      (weighted_high_power - weighted_low_power) / fsk_power_sum;
  g_underwatercomm_rx_debug.filtered_fsk_score =
      (filtered_weighted_high_power - filtered_weighted_low_power) /
      filtered_fsk_power_sum;

  // The decoder uses instantaneous values. The filtered debug values react
  // too slowly for a 1 ms tone inside each 20 ms symbol interval.
  g_latest_result.weighted_low_power = weighted_low_power;
  g_latest_result.weighted_high_power = weighted_high_power;
  g_latest_result.fsk_score = g_underwatercomm_rx_debug.fsk_score;
#endif

  g_latest_result.dominant_frequency_hz = dominant_frequency_hz;
  g_latest_result.dominant_magnitude = dominant_magnitude;
  g_latest_result.target_frequency_hz = GOERTZEL_TARGET_FREQUENCY_HZ;
  g_latest_result.target_magnitude = target_magnitude;
#endif

  g_latest_result.dma_overrun = dma_overrun;
  g_has_result = true;

  g_underwatercomm_rx_debug.processed_block_count = g_block_counter;
  g_underwatercomm_rx_debug.first_raw = samples[0];
  g_underwatercomm_rx_debug.last_raw = samples[FFT_SAMPLE_COUNT - 1U];
  g_underwatercomm_rx_debug.min_raw = g_latest_result.min_raw;
  g_underwatercomm_rx_debug.max_raw = g_latest_result.max_raw;
  g_underwatercomm_rx_debug.average_raw = g_latest_result.average_raw;
  g_underwatercomm_rx_debug.dominant_frequency_hz =
      g_latest_result.dominant_frequency_hz;
  g_underwatercomm_rx_debug.dominant_magnitude =
      g_latest_result.dominant_magnitude;
#if UNDERWATERCOMM_ENABLE_RX_GOERTZEL && UNDERWATERCOMM_ENABLE_RX_GOERTZEL_SWEEP
  g_underwatercomm_rx_debug.filtered_dominant_frequency_hz =
      filtered_dominant_frequency_hz;
  g_underwatercomm_rx_debug.filtered_dominant_magnitude =
      filtered_dominant_magnitude;
  g_underwatercomm_rx_debug.filtered_dominant_power = filtered_dominant_power;
#else
  g_underwatercomm_rx_debug.filtered_dominant_frequency_hz =
      g_latest_result.dominant_frequency_hz;
  g_underwatercomm_rx_debug.filtered_dominant_magnitude =
      g_latest_result.dominant_magnitude;
  g_underwatercomm_rx_debug.filtered_dominant_power = 0.0F;
#endif
  g_underwatercomm_rx_debug.target_frequency_hz =
      g_latest_result.target_frequency_hz;
  g_underwatercomm_rx_debug.target_magnitude = g_latest_result.target_magnitude;
#if UNDERWATERCOMM_ENABLE_RX_GOERTZEL
  g_underwatercomm_rx_debug.dominant_power = dominant_power;
  g_underwatercomm_rx_debug.target_power = target_power;
#else
  g_underwatercomm_rx_debug.dominant_power = 0.0F;
  g_underwatercomm_rx_debug.target_power = 0.0F;
#endif
  g_underwatercomm_rx_debug.dma_overrun = dma_overrun ? 1U : 0U;
  g_underwatercomm_rx_debug.has_result = 1U;
}

}  // namespace

extern "C" {
volatile UnderwaterComm_RxDebugData g_underwatercomm_rx_debug = {};
}

void ResetDebugData() {
  g_underwatercomm_rx_debug.started = 0U;
  g_underwatercomm_rx_debug.sample_rate_hz = SAMPLE_RATE_HZ;
  g_underwatercomm_rx_debug.raw_buffer_address =
      reinterpret_cast<uint32_t>(g_adc_raw_buffer);
  g_underwatercomm_rx_debug.raw_buffer_length = ADC_DMA_SAMPLE_COUNT;
  g_underwatercomm_rx_debug.half_callback_count = 0U;
  g_underwatercomm_rx_debug.full_callback_count = 0U;
  g_underwatercomm_rx_debug.processed_block_count = 0U;
  g_underwatercomm_rx_debug.first_raw = 0U;
  g_underwatercomm_rx_debug.last_raw = 0U;
  g_underwatercomm_rx_debug.min_raw = 0U;
  g_underwatercomm_rx_debug.max_raw = 0U;
  g_underwatercomm_rx_debug.average_raw = 0.0F;
  g_underwatercomm_rx_debug.dominant_frequency_hz = 0.0F;
  g_underwatercomm_rx_debug.dominant_magnitude = 0.0F;
  g_underwatercomm_rx_debug.dominant_power = 0.0F;
  g_underwatercomm_rx_debug.filtered_dominant_frequency_hz = 0.0F;
  g_underwatercomm_rx_debug.filtered_dominant_magnitude = 0.0F;
  g_underwatercomm_rx_debug.filtered_dominant_power = 0.0F;
  g_underwatercomm_rx_debug.target_frequency_hz =
      static_cast<float>(TARGET_FREQUENCY_HZ);
  g_underwatercomm_rx_debug.target_magnitude = 0.0F;
  g_underwatercomm_rx_debug.target_power = 0.0F;
  g_underwatercomm_rx_debug.low_frequency_hz = 0.0F;
  g_underwatercomm_rx_debug.high_frequency_hz = 0.0F;
  g_underwatercomm_rx_debug.low_magnitude = 0.0F;
  g_underwatercomm_rx_debug.high_magnitude = 0.0F;
  g_underwatercomm_rx_debug.low_power = 0.0F;
  g_underwatercomm_rx_debug.high_power = 0.0F;
  g_underwatercomm_rx_debug.weighted_low_power = 0.0F;
  g_underwatercomm_rx_debug.weighted_high_power = 0.0F;
  g_underwatercomm_rx_debug.filtered_low_magnitude = 0.0F;
  g_underwatercomm_rx_debug.filtered_high_magnitude = 0.0F;
  g_underwatercomm_rx_debug.filtered_low_power = 0.0F;
  g_underwatercomm_rx_debug.filtered_high_power = 0.0F;
  g_underwatercomm_rx_debug.filtered_weighted_low_power = 0.0F;
  g_underwatercomm_rx_debug.filtered_weighted_high_power = 0.0F;
  g_underwatercomm_rx_debug.fsk_score = 0.0F;
  g_underwatercomm_rx_debug.filtered_fsk_score = 0.0F;
  g_underwatercomm_rx_debug.sweep_bin_count = 0U;
  for (uint32_t i = 0U; i < UNDERWATERCOMM_RX_DEBUG_SWEEP_BIN_COUNT; ++i) {
    g_underwatercomm_rx_debug.sweep_frequency_hz[i] = 0U;
    g_underwatercomm_rx_debug.sweep_magnitude[i] = 0.0F;
    g_underwatercomm_rx_debug.sweep_power[i] = 0.0F;
    g_underwatercomm_rx_debug.filtered_sweep_magnitude[i] = 0.0F;
    g_underwatercomm_rx_debug.filtered_sweep_power[i] = 0.0F;
#if UNDERWATERCOMM_ENABLE_RX_GOERTZEL && UNDERWATERCOMM_ENABLE_RX_GOERTZEL_SWEEP
    g_filtered_sweep_power[i] = 0.0F;
#endif
  }
#if UNDERWATERCOMM_ENABLE_RX_GOERTZEL && UNDERWATERCOMM_ENABLE_RX_GOERTZEL_SWEEP
  g_sweep_filter_has_history = false;
#endif
  g_underwatercomm_rx_debug.dma_overrun = 0U;
  g_underwatercomm_rx_debug.has_result = 0U;
}

bool RxDriver::Init(ADC_HandleTypeDef *adc, TIM_HandleTypeDef *trigger_timer) {
  if ((adc == nullptr) || (trigger_timer == nullptr)) {
    return false;
  }

  if (g_started) {
    return true;
  }

#if UNDERWATERCOMM_ENABLE_RX_FFT
  if (!g_fft_ready) {
    if (arm_rfft_fast_init_f32(&g_fft_instance, FFT_SAMPLE_COUNT) !=
        ARM_MATH_SUCCESS) {
      return false;
    }

    BuildHannWindow();
    g_fft_ready = true;
  }
#endif

#if UNDERWATERCOMM_ENABLE_RX_GOERTZEL && UNDERWATERCOMM_ENABLE_RX_GOERTZEL_SWEEP
  PrepareGoertzelSweep();
#endif

  g_adc = adc;
  g_trigger_timer = trigger_timer;
  g_ready_block = ReadyBlock::NONE;
  g_dma_overrun = false;
  g_has_result = false;
  g_block_counter = 0U;

  ResetDebugData();

  // Calibrate before starting DMA. If this fails, the ADC is not safe to use yet.
  if (HAL_ADCEx_Calibration_Start(g_adc, ADC_SINGLE_ENDED) != HAL_OK) {
    return false;
  }

  if (HAL_ADC_Start_DMA(g_adc, reinterpret_cast<uint32_t *>(g_adc_raw_buffer),
                        ADC_DMA_SAMPLE_COUNT) != HAL_OK) {
    return false;
  }

  g_started = true;
  g_underwatercomm_rx_debug.started = 1U;

  // TIM6 TRGO now starts the fixed-rate ADC conversions.
  if (HAL_TIM_Base_Start(g_trigger_timer) != HAL_OK) {
    (void)HAL_ADC_Stop_DMA(g_adc);
    g_started = false;
    g_underwatercomm_rx_debug.started = 0U;
    return false;
  }

  return true;
}

bool RxDriver::Stop() {
  HAL_StatusTypeDef timer_status = HAL_OK;
  HAL_StatusTypeDef adc_status = HAL_OK;

  if (g_trigger_timer != nullptr) {
    timer_status = HAL_TIM_Base_Stop(g_trigger_timer);
  }

  if (g_adc != nullptr) {
    adc_status = HAL_ADC_Stop_DMA(g_adc);
  }

  __disable_irq();
  g_ready_block = ReadyBlock::NONE;
  g_dma_overrun = false;
  g_started = false;
  g_underwatercomm_rx_debug.started = 0U;
  __enable_irq();

  return (timer_status == HAL_OK) && (adc_status == HAL_OK);
}

void RxDriver::Process() {
  ReadyBlock block = ReadyBlock::NONE;
  bool dma_overrun = false;

  __disable_irq();
  block = g_ready_block;
  g_ready_block = ReadyBlock::NONE;
  dma_overrun = g_dma_overrun;
  g_dma_overrun = false;
  __enable_irq();

  if (block == ReadyBlock::NONE) {
    return;
  }

  const uint32_t offset =
      (block == ReadyBlock::FIRST_HALF) ? 0U : FFT_SAMPLE_COUNT;
  AnalyzeBlock(&g_adc_raw_buffer[offset], dma_overrun);
}

bool RxDriver::GetLatestResult(RxAnalysisResult *result) {
  if ((result == nullptr) || !g_has_result) {
    return false;
  }

  *result = g_latest_result;
  return true;
}

const volatile uint16_t *RxDriver::GetRawBuffer() {
  return g_adc_raw_buffer;
}

size_t RxDriver::GetRawBufferLength() {
  return ADC_DMA_SAMPLE_COUNT;
}

void RxDriver::OnAdcHalfComplete(ADC_HandleTypeDef *adc) {
  if (adc == g_adc) {
    ++g_underwatercomm_rx_debug.half_callback_count;
  }

  MarkBlockReady(adc, ReadyBlock::FIRST_HALF);
}

void RxDriver::OnAdcComplete(ADC_HandleTypeDef *adc) {
  if (adc == g_adc) {
    ++g_underwatercomm_rx_debug.full_callback_count;
  }

  MarkBlockReady(adc, ReadyBlock::SECOND_HALF);
}

}  // namespace underwatercomm

extern "C" void HAL_ADC_ConvHalfCpltCallback(ADC_HandleTypeDef *hadc) {
  underwatercomm::RxDriver::OnAdcHalfComplete(hadc);
}

extern "C" void HAL_ADC_ConvCpltCallback(ADC_HandleTypeDef *hadc) {
  underwatercomm::RxDriver::OnAdcComplete(hadc);
}
