Frrrrrrrrrank/Underwater-Communication/software/Underwatercomm_core/maintask.hpp

#ifndef UNDERWATERCOMM_CORE_MAINTASK_HPP
#define UNDERWATERCOMM_CORE_MAINTASK_HPP

#ifdef __cplusplus
extern "C" {
#endif

void UnderwaterComm_MainTask_Init(void);
void UnderwaterComm_MainTask_Run(void);

#ifdef __cplusplus
}
#endif

#endif /* UNDERWATERCOMM_CORE_MAINTASK_HPP */
