Frrrrrrrrrank/Underwater-Communication/(commit log)

2026-06-12 layout finish,send manufature
    [Amplifier.kicad_sch, MCU.kicad_sch, Power.kicad_sch, underwaterCom.kicad_pcb]
2026-07-09 update 75kHz, can filter and see manitude difference
